DaQi0510/SM2200-Ulimate/PCB/Ven2.0/SM2200料单.xlsx

Comment | Designator | Footprint | Quantity | Value | 备注
电容部分 | C1, C2, C3, C4, C5, C6, C7, C8, C9, C10, C11, C12, C14, C15, C18,C20, C21, C22, C23, C24, C25, C26,C30, C59, C61,C63, C68, C69, C70, C72, C74,C76,C80, C81,C84,C86,C88,C89, C90,C92,C94,C99,C101,C102, C103,C105, C108,C110,C112,C114,C117,C124,C125 | 0603 | 53 | 0.1uF | 电路板背面电容均为0603封装，0.1uF电容
 | C29, C32, C34, C36, C38, C40, C41, C44, C45, C47, C50, C51, C54, C55, C58 | 0805 | 15 | 0.1uF
 | C17,C19 | 0603 | 2 | 20pF
 | C13,C16,C91,C93,C98,C100,C104,C109,C111,C113,C115,C116 | 0603 | 12 | 2.2uF
 | C27 | 0603 | 1 | 330pF
 | C122, C123 | 0603 | 2 | 22pF
 | C62,C64,C75,C82 | 0603 | 4 | 10nF
 | C65, C71,C77,C83 | 0603 | 4 | 18pF
 | C85 | 0603 | 1 | 3pF
 | C87 | 0603 | 1 | 12pF
 | C95 | 0603 | 1 | 56pF
 | C96 | 0603 | 1 | 1uF
 | C97 | 0603 | 1 | 220pF
 | C106 | 0603 | 1 | 1nF
 | C107 | 0603 | 1 | 5.6pF
 | C119 | 0603 | 1 | 18nF
 | C120 | 0603 | 1 | 270pF
 | C121 | 0603 | 1 | 130pF
 | C118 | 0805 | 1 | 10uF
 | C28, C33 | 钽电容3528 | 2 | 10uF
 | C48, C49, C52, C53, C56, C57, C66, C67,C78, C79 | 钽电容1206 | 10 | 10uF
 | C60,C73 | 钽电容1206 | 2 | 3.3uF
 | C31, C37, C39 | 贴片铝电容8*10.3 | 3 | 100uF
 | C43, C46 | 贴片铝电容8*10.3 | 2 | 220uF | 材料中没有，需购买
 | C35, C42 | 贴片铝电容10*10 | 2 | 470uF
电阻部分 | R1, R2, R3, R4, R5, R6, R7, R8, R10, R13, R15, R32, R33, R36, R37, R39, R41, R42, R43, R45, R46, R47, R49, R50, R51, R52, R53, R54, R55, R63, R64, R66, R67, R68, R69, R70, R71, R72, R73, R74, R75, R82, R83, R85, R87, R92, R93, R94, R97, R98, R101, R102, R104, R108, | 0603 | 54 | 10K
 | R9, R17 | 0603 | 2 | 47K
 | R11, R18 | 0603 | 2 | 0R
 | R12, R16 | 0603 | 2 | 22R
 | R14 | 0603 | 1 | 120R
 | R106, R107, R109, R19, R20, R21, R22, R27, R28, R29, R44, R48, R62, R65, R96,R103, R105 | 0603 | 17 | 1K
 | R23, R24, R25, R26, R30, R34, R38, R40, R110, R111 | 0603 | 10 | 4.7K
 | R61,R80, R112, | 0603 | 3 | 1M
 | R31, R100 | 0603 | 2 | 100R
 | R35 | 0603 | 1 | 100K
 | R56, R58, R59, R60, R77, R78, R79, R81 | 0603 | 8 | 50R
 | R57, R76 | 0603 | 2 | 28.7K
 | R84 | 0603 | 1 | 4.99K
 | R86 | 0603 | 1 | 2.2K
 | R88, R89, R90, R91 | 0603 | 4 | 100K
 | R95 | 0603 | 1 | 3.3K
 | R99 | 0603 | 1 | 330R
电感部分 | L1, L5, L6, L7, L8, L9, L10 | 0805 | 7 | 10uH
 | L2, L12 | 贴片7.8*7*5 | 2 | 330uH
 | L3, L4 | SLF6025 电感 | 2 | 33uH
 | L11 | 1206 | 1 | 1uH
 | L13 | 直插 | 1 | 18mH
三极管 | Q1, Q2, Q3, Q4, Q5, Q6, Q8, Q9, Q10, Q11 | 贴片 | 10 | BC847
 | Q7 | 贴片 | 1 | BC857
二极管 | D1, D2 | 贴片 | 2 | SMBJ20A
 | D3, D4 | 贴片 | 2 | IN5824 | 可能材料里没有，需购买
 | D5, D6, D7, D8 | 贴片 | 4 | SSA34
晶振 | X1 | 3225 | 1 | 8M
 | X2, X3 | 3225 | 1 | 25M
 | X4 | 3225 | 1 | 10M
 | U1 | 贴片 | 1 | STM32F407ZET6
 | U2 | 10*2排针 | 1 | 双排针
 | U3 | 贴片 | 1 | AT24C02
 | U4 | 贴片 | 1 | MAX3485
 | U5 | 贴片 | 1 | MAX3232
 | U6 | 贴片 | 1 | FDC6326L
 | U7，U8 | 贴片 |  |  | 不用焊接
 | U9 | 贴片 | 1 | LM2576HVS-15V
 | U10，U11 | 贴片 | 2 | LM2596-5
 | U12, U13, U14 | 贴片 | 3 | LT1963-3.3
 | U15, U17 | 直插 | 2 | RJ45接口
 | U16, U18 | 贴片 | 2 | W5200
 | U19 | 贴片 | 1 | SM2200
 | U20 | 贴片 | 1 | OPA564AIDWDR
 | B1 | 直插 | 1 | BNC
 | J1 | 直插 | 1 | DB9
 | J2 | 直插 | 1 | 三脚航空插头 | 不用焊接
 | K1 | 贴片 | 1 | 贴片按键
 | K2, K4 | 直插 | 2 | 选择开关
 | K3 | 直插 | 1 | T型接头
 | 右下方8*2焊盘焊接上排针
