DaQi0510/SM2200-Ulimate/PCB/Ven2.0/SM2200-PCB-2.pdf

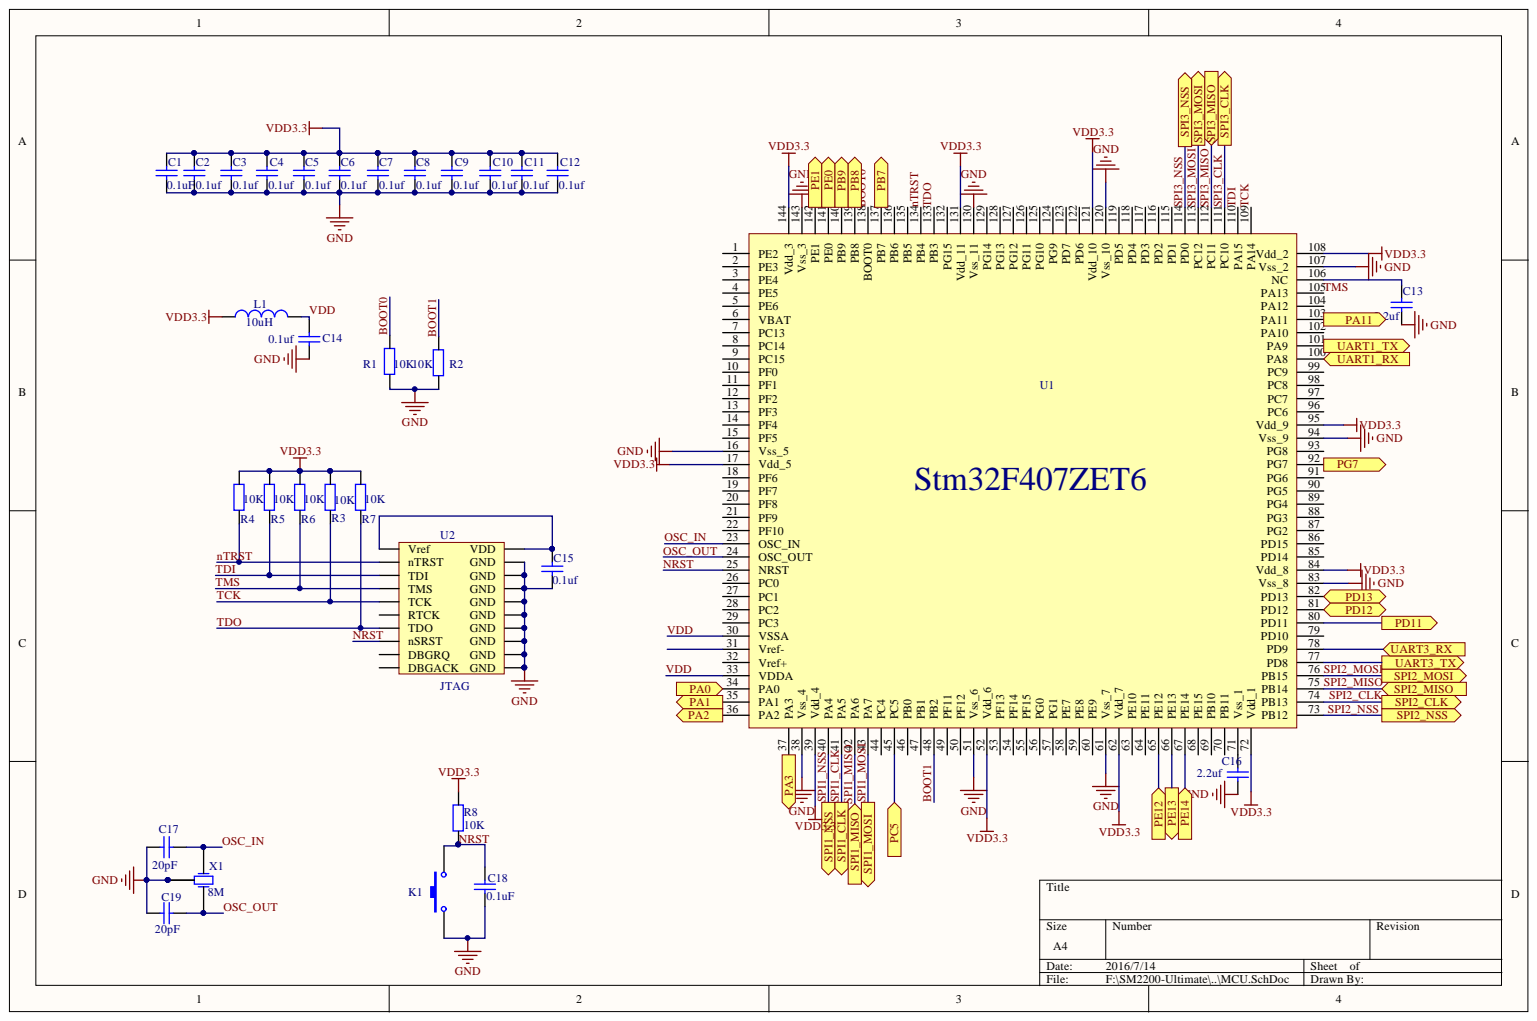
[picture p1: page 1]

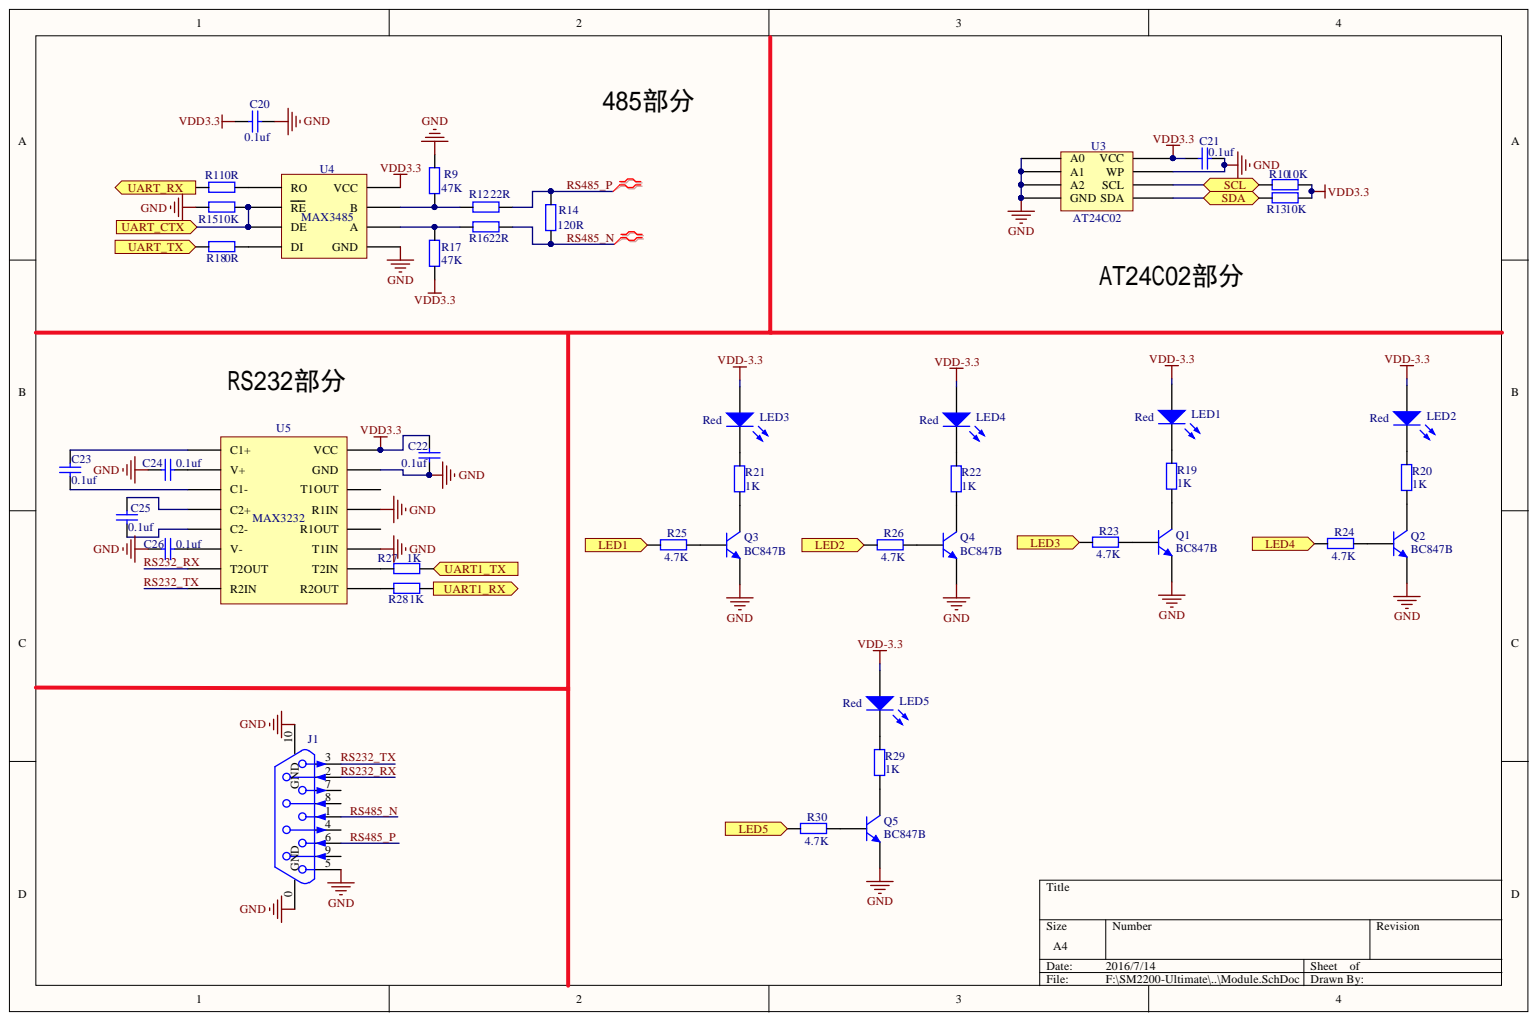
[picture p2: page 2]

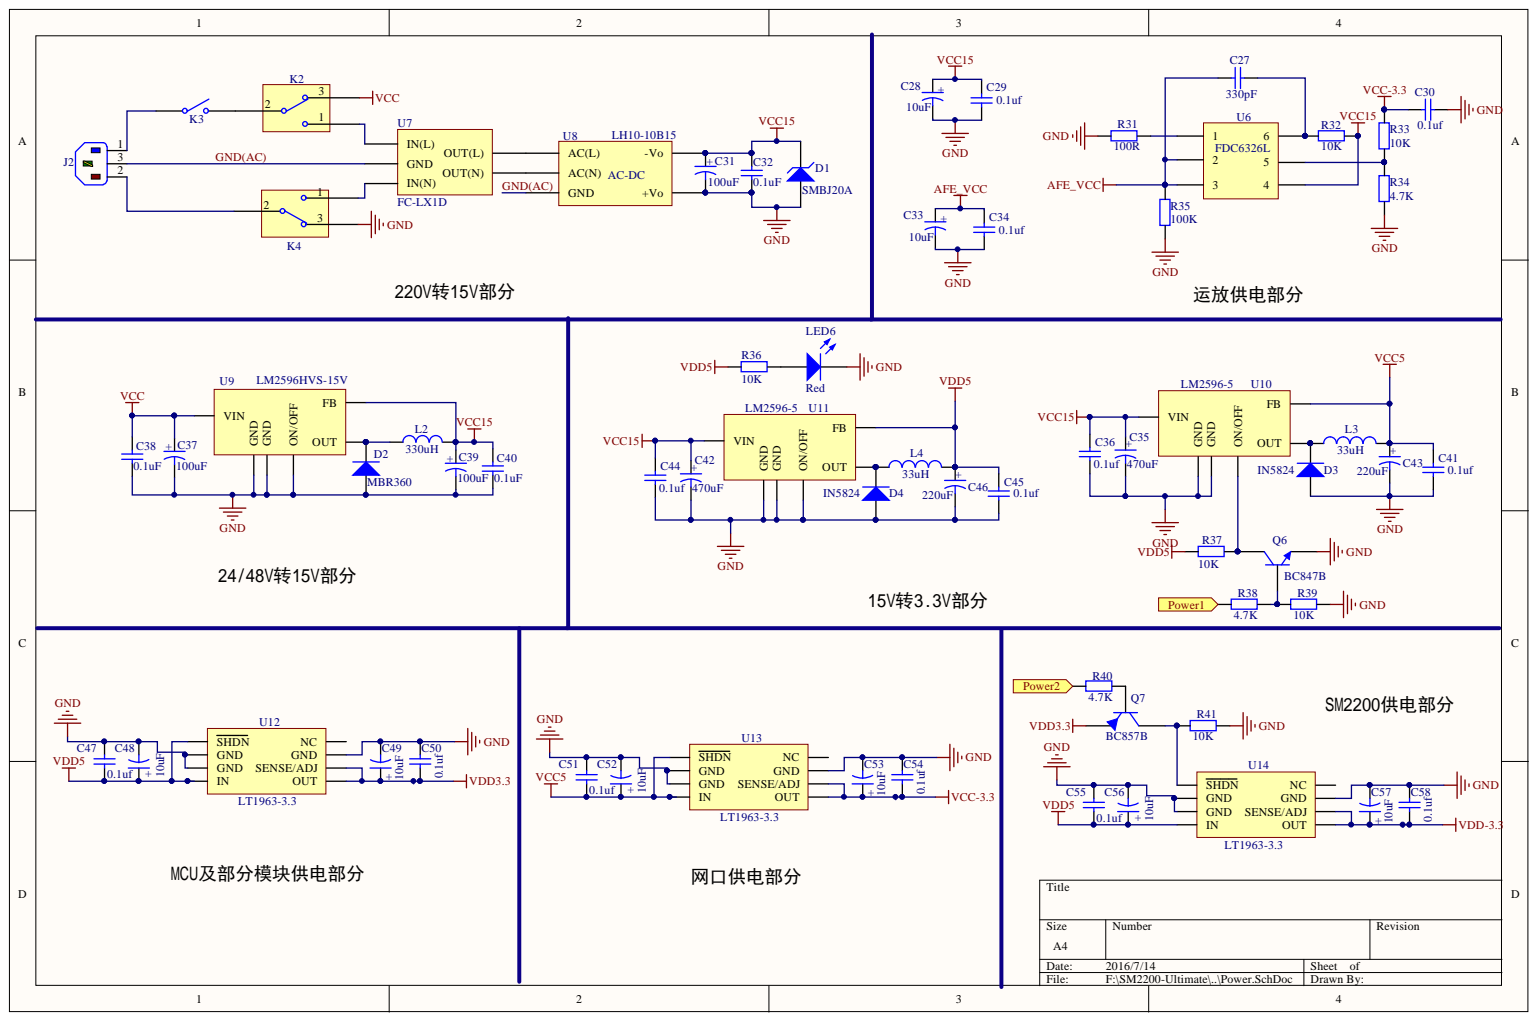
[picture p3: page 3]

MBR360 | 100uF

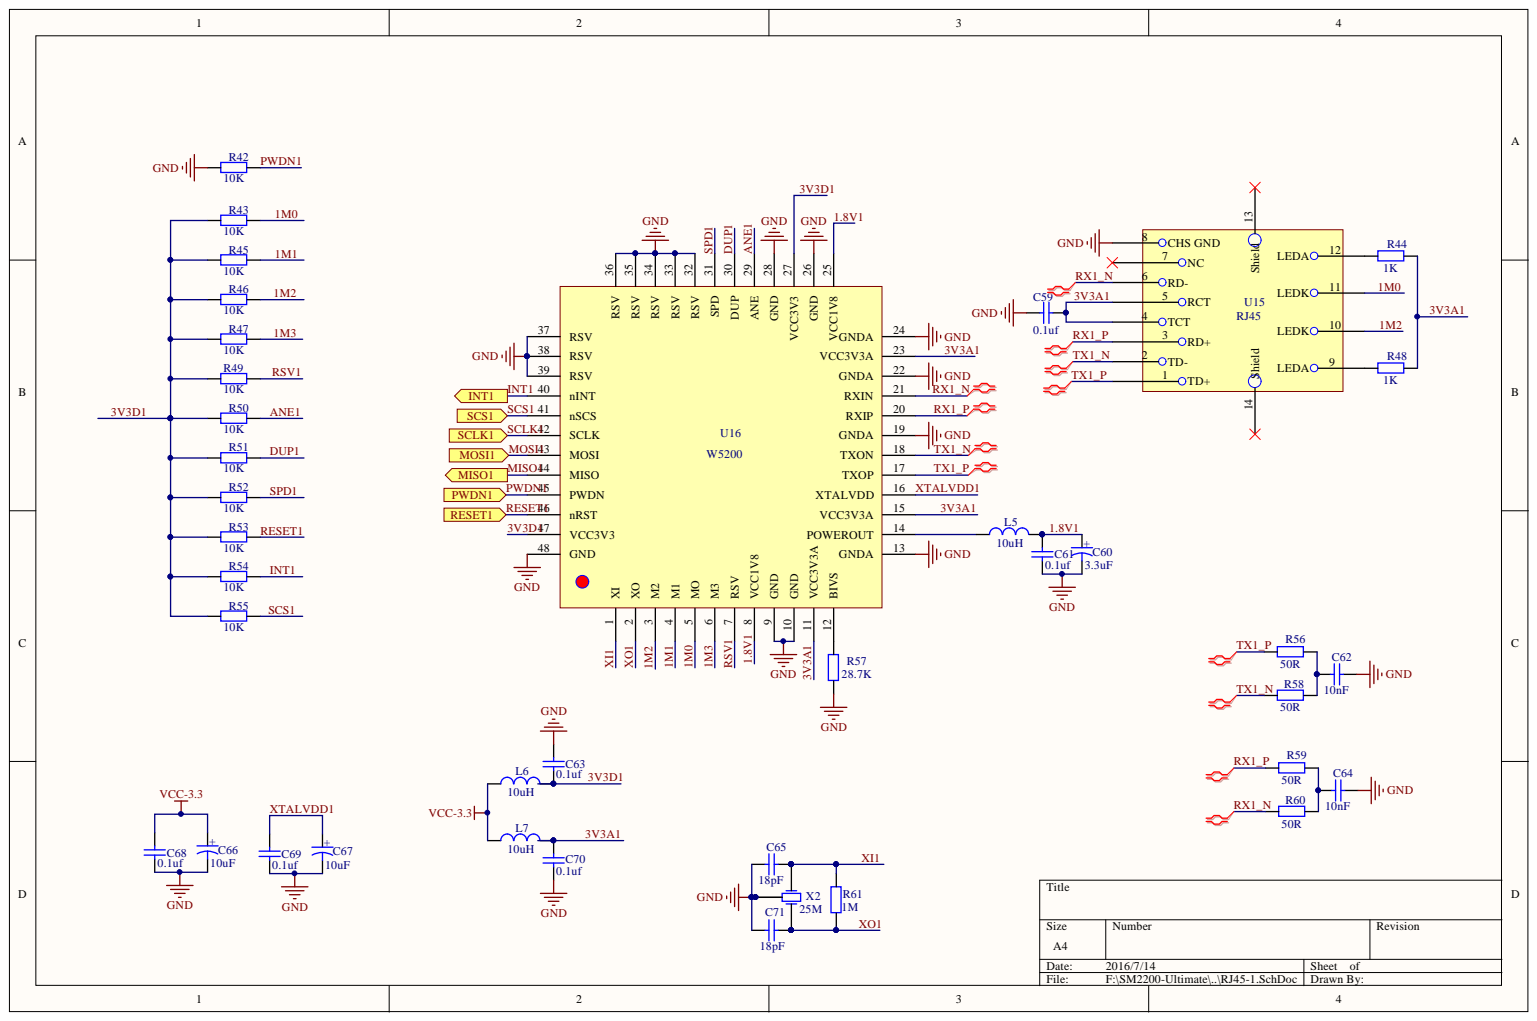
[picture p4: page 4]

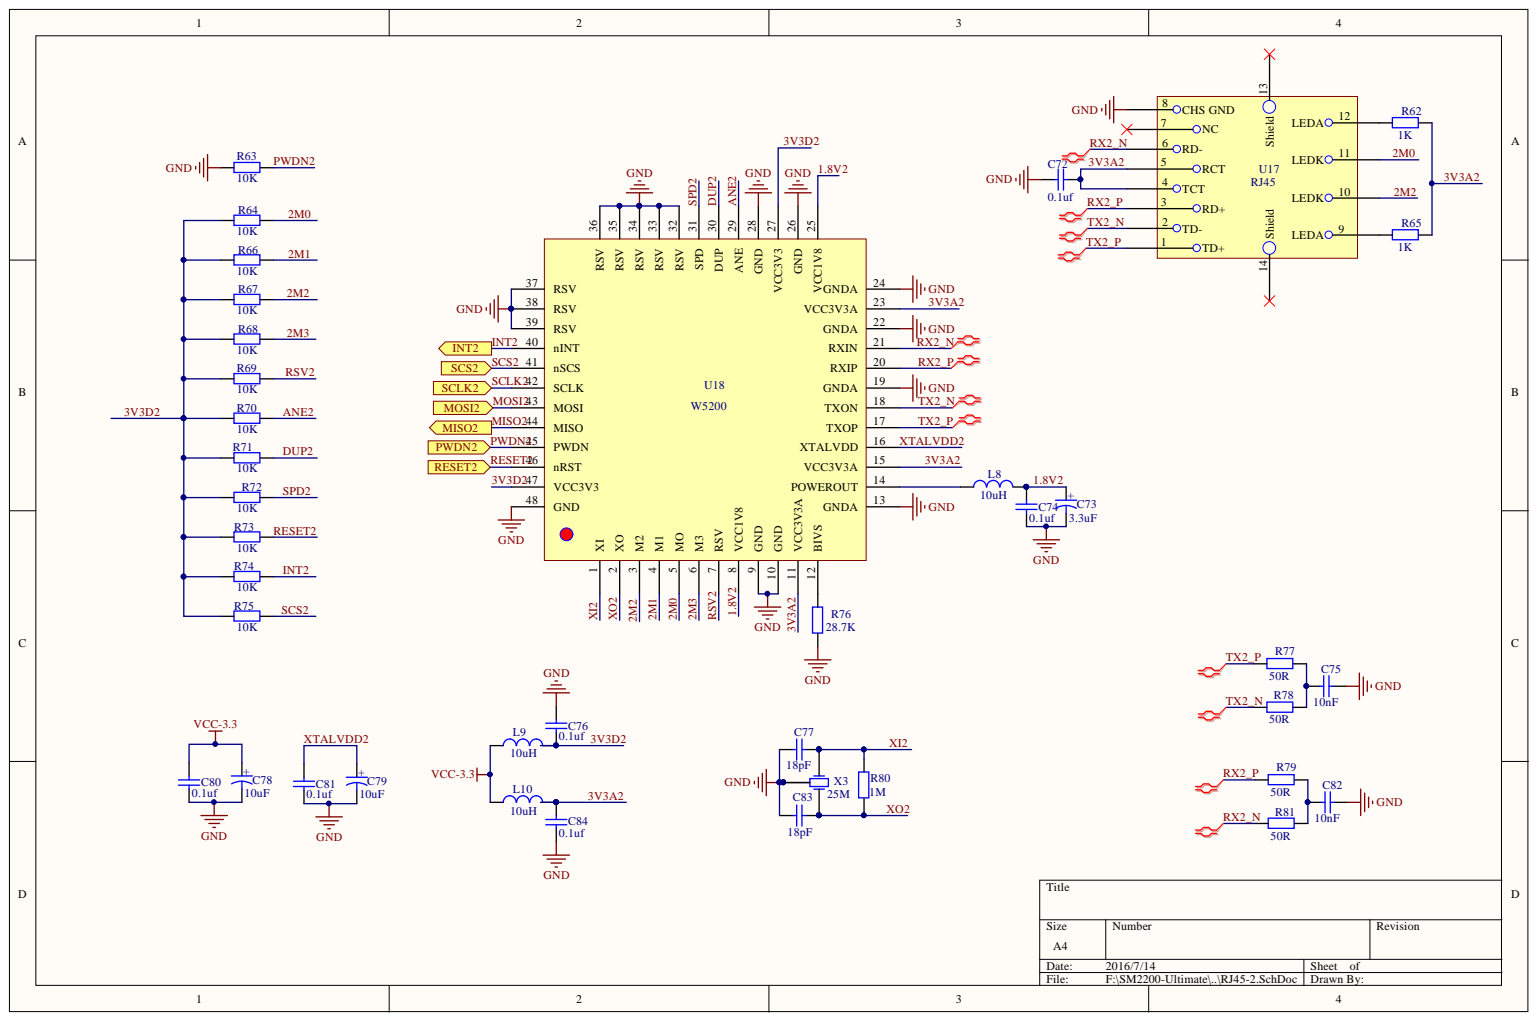
[picture p5: page 5]

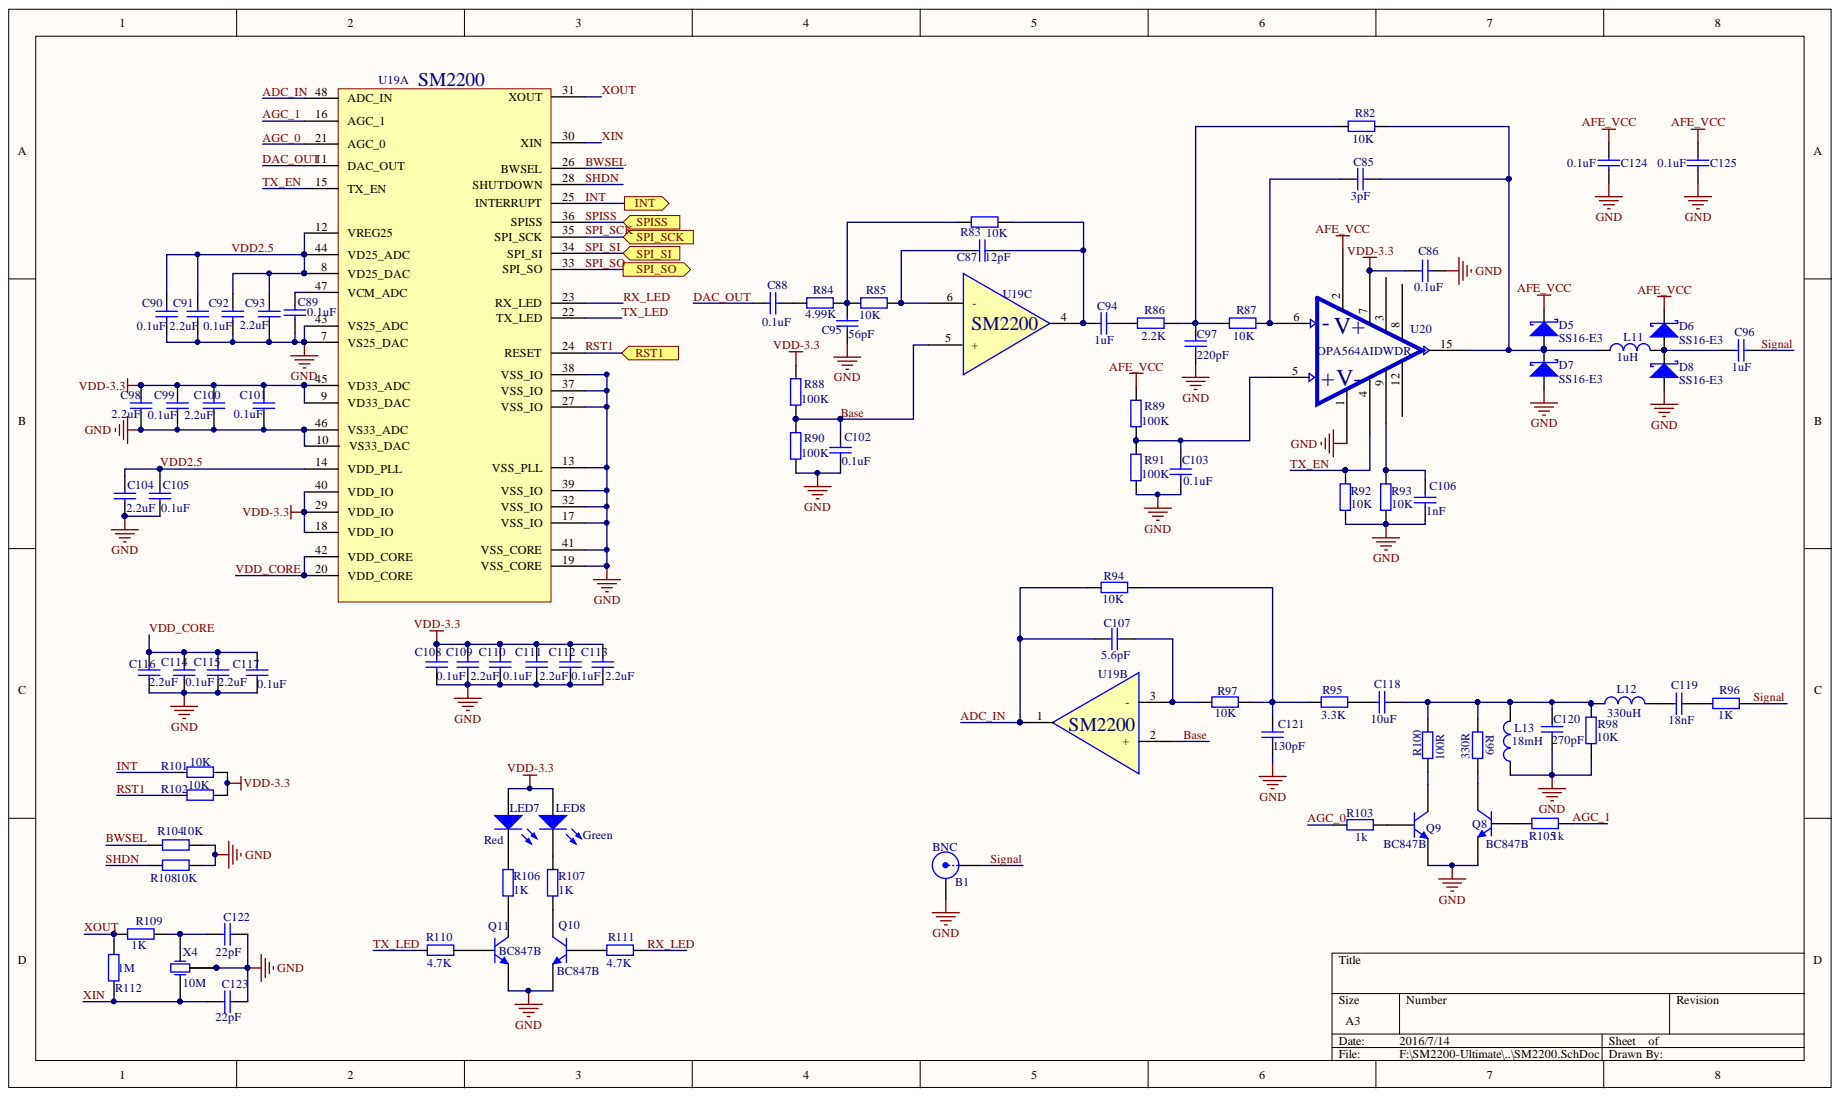
[picture p6: page 6]

AFE_VCC 6 | GND

VDD2.5 | VD25_ADC 44

C99 | C100 | C101 | VD33_DAC 9

VS33_ADC 46

Size A3 | Number | Revision

Date: 2016/7/14 | Sheet of
File: F:\SM2200-Ultimate\..\SM2200.SchDoc | Drawn By:

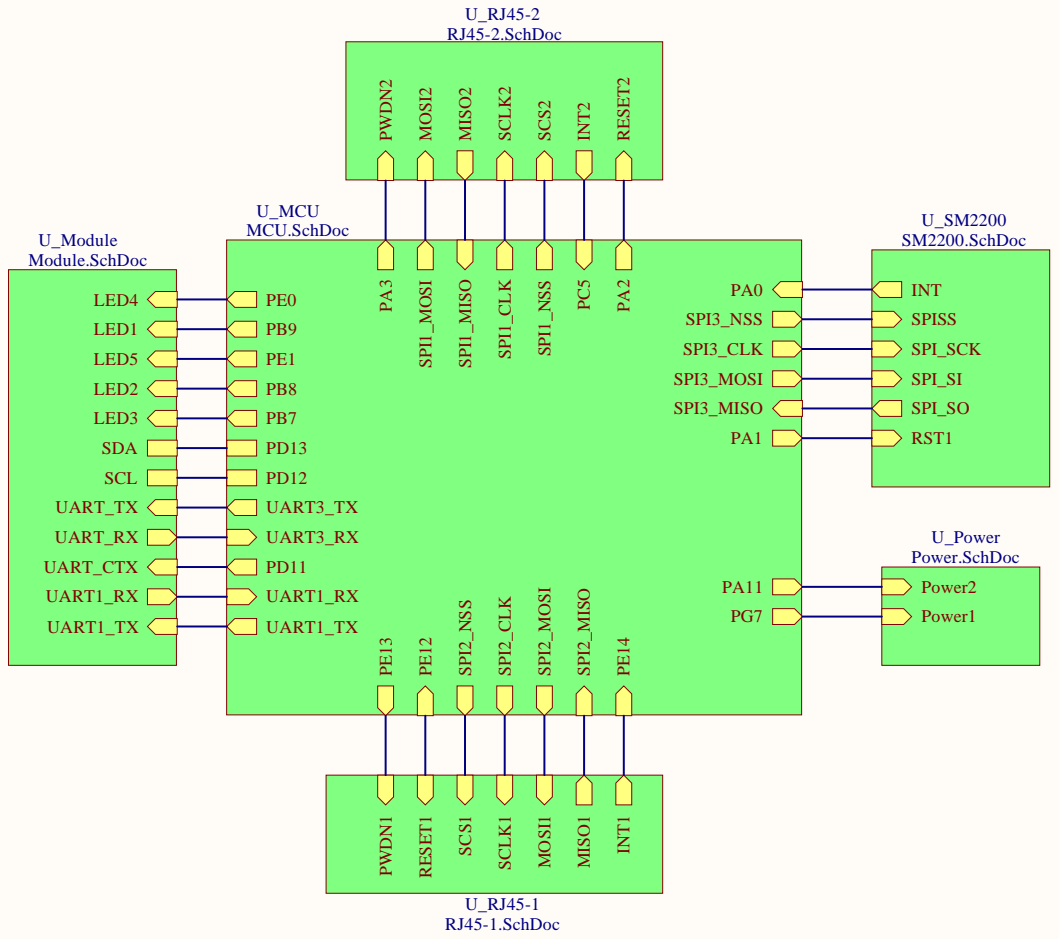
[picture p7: page 7]

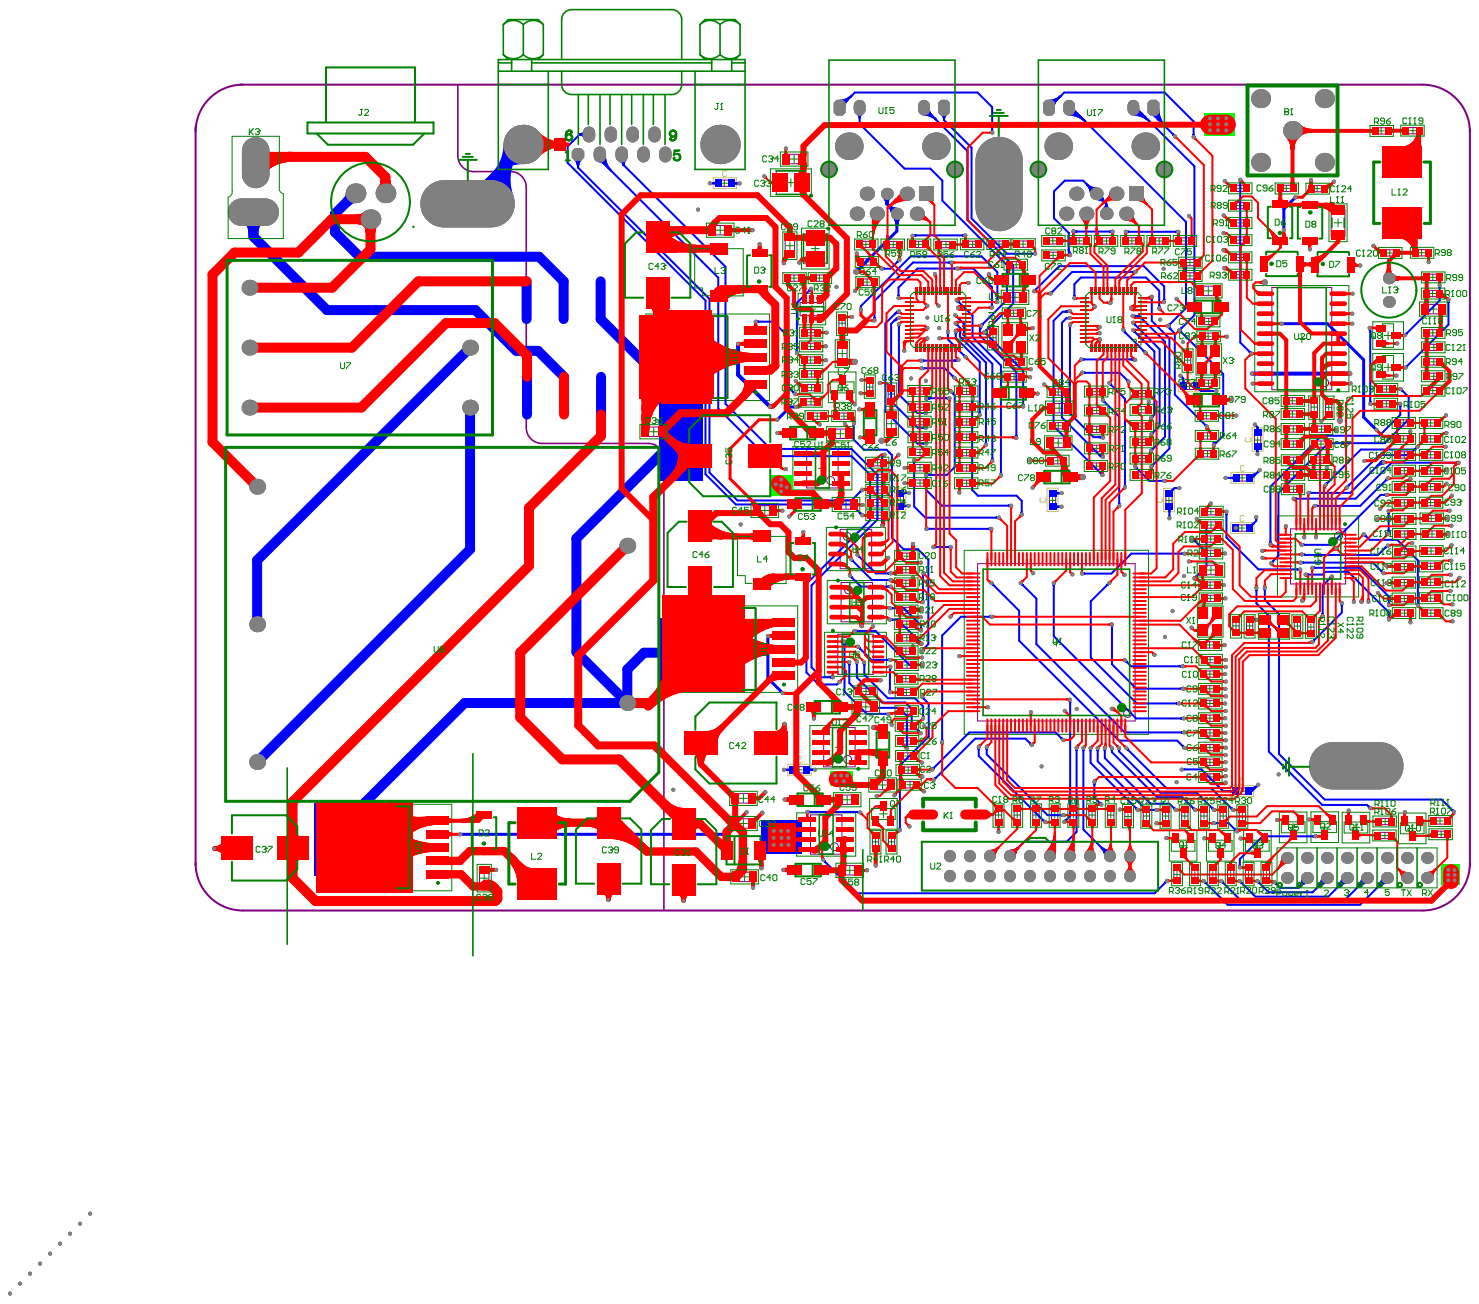
[picture p8: page 8]
