DaQi0510/SM2200-Ulimate/PCB/Ven3.0/Main/SM2200.pdf

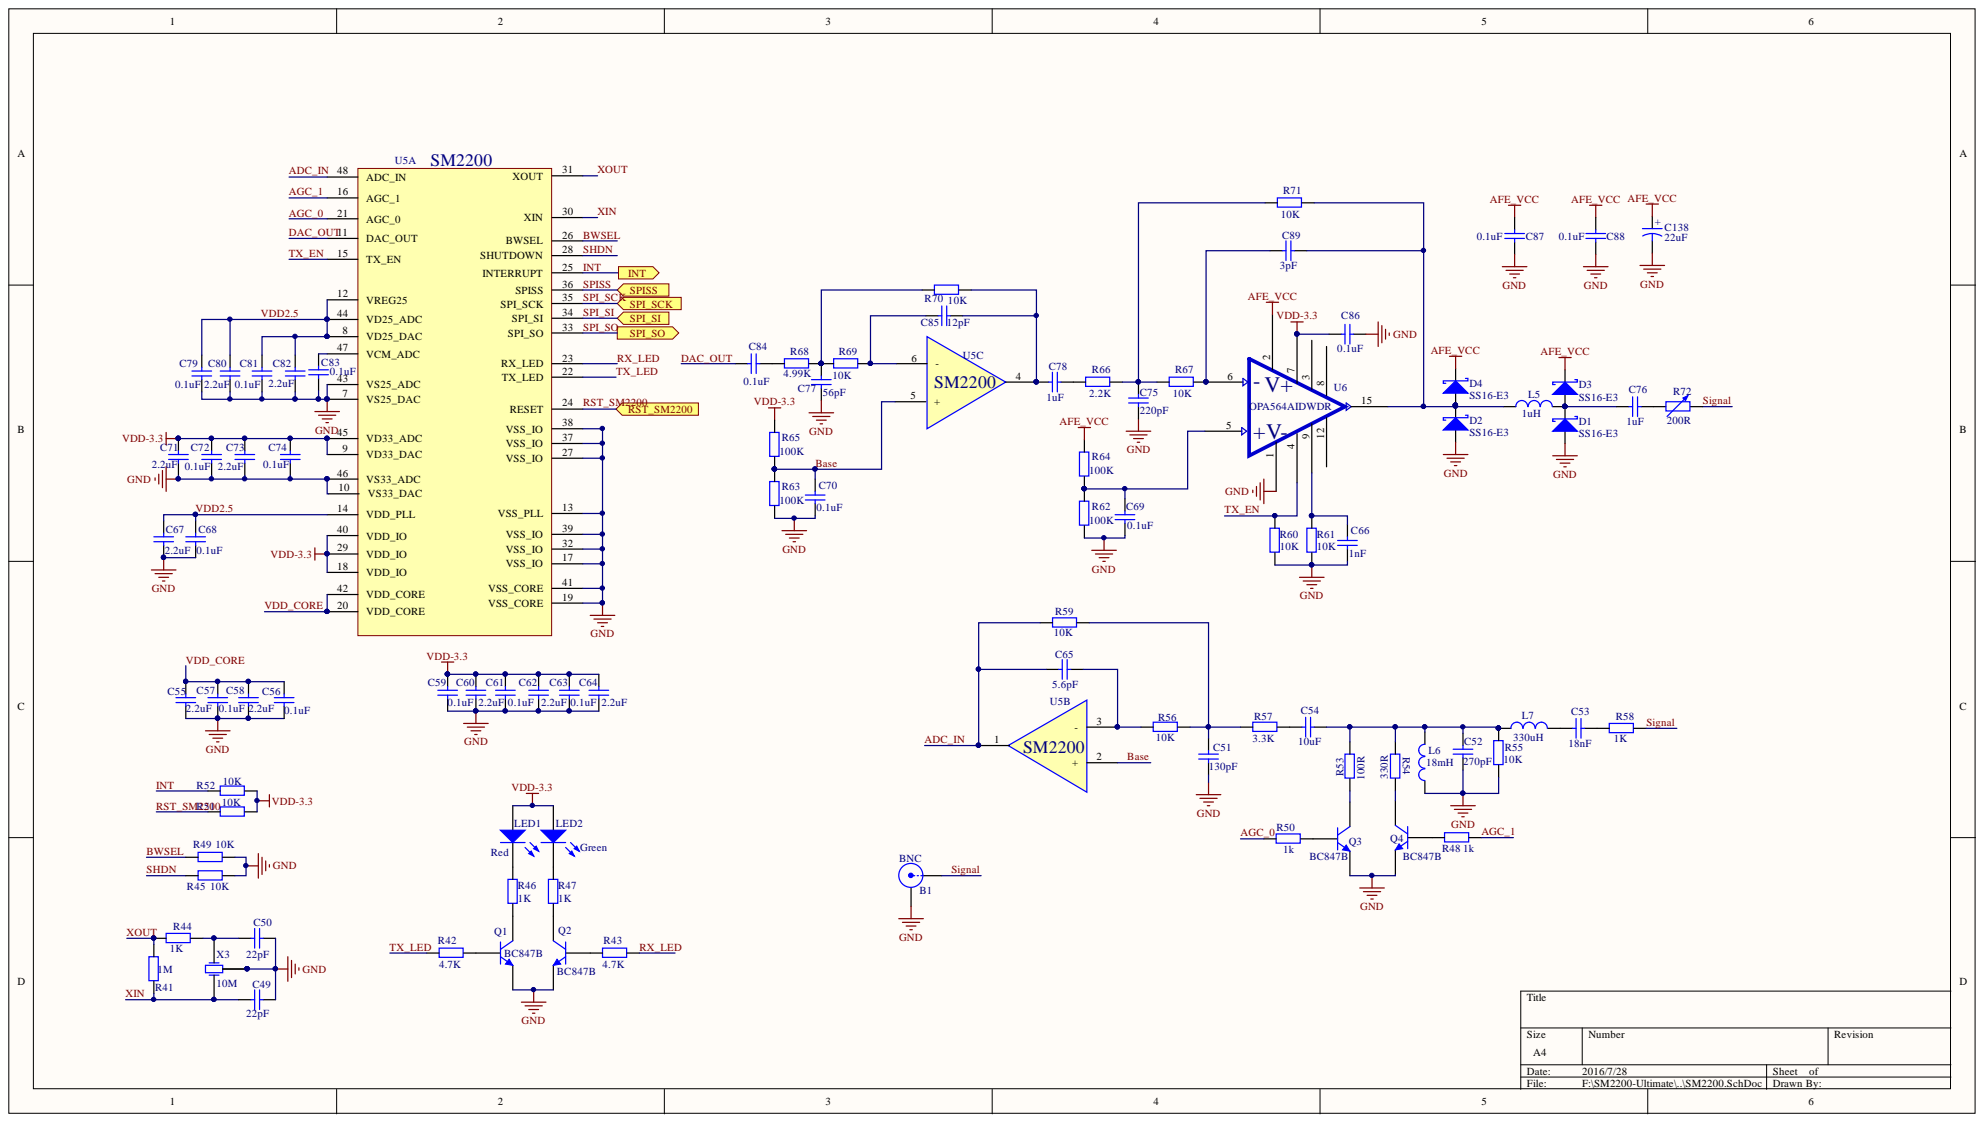
[picture p24: page 1]

AFE_VCC 6 | C86

VDD2.5

C72 | C73 | C74 | VD33_DAC 9

VS33_ADC 46

Size A4 | Number | Revision

Date: 2016/7/28 | Sheet of
File: F:\SM2200-Ultimate\..\SM2200.SchDoc | Drawn By:
