DaQi0510/SM2200-Ulimate/(list of files, drawings)

Other design files:
PCB/Ven1.0/GC2200.SchDoc
PCB/Ven1.0/MCU.SchDoc
PCB/Ven1.0/Module.SchDoc
PCB/Ven1.0/Power.SchDoc
PCB/Ven1.0/RJ45-2.SchDoc
PCB/Ven1.0/RJ45.SchDoc
PCB/Ven1.0/SM2200-PCB-1.PrjPCB
PCB/Ven1.0/Top.SchDoc
PCB/Ven2.0/History/Board.~(2).PcbDoc
PCB/Ven2.0/History/Board.~(3).PcbDoc
PCB/Ven2.0/History/Board.~(39).PcbDoc
PCB/Ven2.0/History/Board.~(48).PcbDoc
PCB/Ven2.0/History/MCU.~(2).SchDoc
PCB/Ven2.0/History/MCU.~(5).SchDoc
PCB/Ven2.0/History/Power.~(1).SchDoc
PCB/Ven2.0/History/Power.~(5).SchDoc
PCB/Ven2.0/MCU.SchDoc
PCB/Ven2.0/Module.SchDoc
PCB/Ven2.0/Power.SchDoc
PCB/Ven2.0/RJ45-1.SchDoc
PCB/Ven2.0/RJ45-2.SchDoc
PCB/Ven2.0/SM2200-PCB-2.PrjPCB
PCB/Ven2.0/SM2200.SchDoc
PCB/Ven2.0/Top.SchDoc
PCB/Ven3.0/HighPower/HighPower.PcbDoc
PCB/Ven3.0/HighPower/HighPower.SchDoc
PCB/Ven3.0/HighPower/SM2200_POWER.PrjPcb
PCB/Ven3.0/Main/MCU.SchDoc
PCB/Ven3.0/Main/Module.SchDoc
PCB/Ven3.0/Main/Power.SchDoc
PCB/Ven3.0/Main/SM2200.SchDoc
PCB/Ven3.0/Main/SM2200_PCB.PrjPCB
PCB/Ven3.0/Main/Top.SchDoc
PCB/Ven3.0/Main/W5500_1.SchDoc
PCB/Ven3.0/Main/W5500_2.SchDoc
