DaQi0510/SM2200-Ulimate/Stm32_Code/Ven2.0/HardWare/UART/UART.c

#include "uart.h"	
#include "led.h"
#include "stm32f4xx_rcc.h"

extern u8 Flag101;      //101规约数据接收标志
u8 StartFlag;           //报文开始标志
u8 Message101[256];    //存放接收到的101规约
u8 Index101;           //数组索引     

void uart_init(u32 bound)
{
   //GPIO端口设置
  GPIO_InitTypeDef GPIO_InitStructure;
	USART_InitTypeDef USART_InitStructure;
	NVIC_InitTypeDef NVIC_InitStructure;
	
	RCC_AHB1PeriphClockCmd(RCC_AHB1Periph_GPIOA,ENABLE); //使能GPIOA时钟
	RCC_APB2PeriphClockCmd(RCC_APB2Periph_USART1,ENABLE);//使能USART1时钟
  
	RCC_AHB1PeriphClockCmd(RCC_AHB1Periph_GPIOA, ENABLE);//使能GPIOA时钟
  GPIO_InitStructure.GPIO_Pin = GPIO_Pin_8;         
  GPIO_InitStructure.GPIO_Mode = GPIO_Mode_IN;//普通输入模式
  GPIO_InitStructure.GPIO_Speed = GPIO_Speed_100MHz;//100M
  GPIO_InitStructure.GPIO_PuPd = GPIO_PuPd_UP;//上拉
  GPIO_Init(GPIOA, &GPIO_InitStructure);//初始化GPIO	
	 
	//串口1对应引脚复用映射
	GPIO_PinAFConfig(GPIOA,GPIO_PinSource9,GPIO_AF_USART1); //GPIOA9复用为USART1
	GPIO_PinAFConfig(GPIOA,GPIO_PinSource10,GPIO_AF_USART1); //GPIOA10复用为USART1
	
	//USART1端口配置
  GPIO_InitStructure.GPIO_Pin = GPIO_Pin_9 | GPIO_Pin_10; //GPIOA9与GPIOA10
	GPIO_InitStructure.GPIO_Mode = GPIO_Mode_AF;//复用功能
	GPIO_InitStructure.GPIO_Speed = GPIO_Speed_50MHz;	//速度50MHz
	GPIO_InitStructure.GPIO_OType = GPIO_OType_PP; //推挽复用输出
	GPIO_InitStructure.GPIO_PuPd = GPIO_PuPd_UP; //上拉
	GPIO_Init(GPIOA,&GPIO_InitStructure); //初始化PA9，PA10

   //USART1 初始化设置
	USART_InitStructure.USART_BaudRate = bound;//波特率设置
	USART_InitStructure.USART_WordLength = USART_WordLength_8b;//字长为8位数据格式
	USART_InitStructure.USART_StopBits = USART_StopBits_1;//一个停止位
	USART_InitStructure.USART_Parity = USART_Parity_No;//无奇偶校验位
	USART_InitStructure.USART_HardwareFlowControl = USART_HardwareFlowControl_None;//无硬件数据流控制
	USART_InitStructure.USART_Mode = USART_Mode_Rx | USART_Mode_Tx;	//收发模式
  USART_Init(USART1, &USART_InitStructure); //初始化串口1
	
  USART_Cmd(USART1, ENABLE);  //使能串口1 
	

	USART_ITConfig(USART1, USART_IT_RXNE, ENABLE);//开启相关中断

	//Usart1 NVIC 配置
  NVIC_InitStructure.NVIC_IRQChannel = USART1_IRQn;//串口1中断通道
	NVIC_InitStructure.NVIC_IRQChannelPreemptionPriority=2;//抢占优先级3
	NVIC_InitStructure.NVIC_IRQChannelSubPriority =2;		//子优先级3
	NVIC_InitStructure.NVIC_IRQChannelCmd = ENABLE;			//IRQ通道使能
	NVIC_Init(&NVIC_InitStructure);	//根据指定的参数初始化VIC寄存器、

}

void USART_Send(u8 *Message,u8 Length)
{
	u8 i;
	for(i=0;i<Length;i++)
	{
		USART1->DR =Message[i];
		while((USART1->SR&0X40)==0);//等待发送结束
	}
}

void USART1_IRQHandler(void)                	//串口1中断服务程序
{
  u8 Res;
	if(USART_GetITStatus(USART1, USART_IT_RXNE) != RESET)  //接收中断(接收到的数据必须是0x0d 0x0a结尾)
	{
		Res =USART_ReceiveData(USART1);
	  if((StartFlag==0)&&((Res==0x10)||(Res==0x68)))
		{
			StartFlag=1;
			Index101=0;
		}
		Message101[Index101]=Res;
		Index101++;
		if((Message101[0]==0x10)&&(Index101==5))    //固定帧格式，接收完成
		{
//			Flag101=1;
			StartFlag=0;
		}
		if((Message101[0]==0x68)&&(Index101==Message101[1]+6))    //固定帧格式，接收完成
		{
//			Flag101=1;
			StartFlag=0;
		}
	}  
  LED2 =!LED2 ;	
} 
