DaQi0510/SM2200-Ulimate/Stm32_Code/Ven1.0/HardWare/LCD/LCD.h

#ifndef __LCD_H
#define __LCD_H

#include "stm32f4xx_gpio.h"
#include "delay.h"

#define SET_LCD_DC GPIO_SetBits(GPIOF,GPIO_Pin_0)    //  PF0  片选
#define CLR_LCD_DC GPIO_ResetBits(GPIOF,GPIO_Pin_0)

#define SET_LCD_RST GPIO_SetBits(GPIOF,GPIO_Pin_1)    //  PF1  复位
#define CLR_LCD_RST GPIO_ResetBits(GPIOF,GPIO_Pin_1)

#define SET_LCD_SDA GPIO_SetBits(GPIOF,GPIO_Pin_2)   //  PF2  数据位
#define CLR_LCD_SDA GPIO_ResetBits(GPIOF,GPIO_Pin_2)

#define SET_LCD_SCL GPIO_SetBits(GPIOF,GPIO_Pin_3)    //  PF3  数据位
#define CLR_LCD_SCL GPIO_ResetBits(GPIOF,GPIO_Pin_3)

 void LCD_Init(void);
 void LCD_P6x8Str(u8 x,u8 y,u8 ch[]);
 void LCD_ShowNum(u8 x,u8 y, unsigned int num);
 void LCD_Show_M(u8 y,unsigned long int num);
 
#endif
