DaQi0510/SM2200-Ulimate/Stm32_Code/Ven2.0/STM32F407/USER/spi.c

#include "spi.h"

/******************************************************************************/
/*                              SPI1初始化                                    */
/******************************************************************************/

void spi1_init(void)
{	 
	GPIO_InitTypeDef  GPIO_InitStructure;
  SPI_InitTypeDef  SPI_InitStructure;
	
	///////////////////////////////////////////////////////////////////////
	////                        SPI1 GPIO配置                          ////
	///////////////////////////////////////////////////////////////////////
	
  RCC_AHB1PeriphClockCmd(RCC_AHB1Periph_GPIOA, ENABLE);//使能GPIOA时钟

	GPIO_InitStructure.GPIO_Pin = GPIO_Pin_5 | GPIO_Pin_6;//PA5 PA6复用功能输出	
  GPIO_InitStructure.GPIO_Mode = GPIO_Mode_AF;//复用功能
  GPIO_InitStructure.GPIO_OType = GPIO_OType_PP;//推挽输出
  GPIO_InitStructure.GPIO_Speed = GPIO_Speed_100MHz;//100MHz
  GPIO_InitStructure.GPIO_PuPd = GPIO_PuPd_UP;//上拉
  GPIO_Init(GPIOA, &GPIO_InitStructure);//初始化
	
	GPIO_PinAFConfig(GPIOA,GPIO_PinSource5,GPIO_AF_SPI1); //PA5复用为 SPI1
	GPIO_PinAFConfig(GPIOA,GPIO_PinSource6,GPIO_AF_SPI1); //PA6复用为 SPI1

	///////////////////////////////////////////////////////////////////////
	////                         SPI1配置                               ////
	///////////////////////////////////////////////////////////////////////
	
	RCC_APB2PeriphClockCmd(RCC_APB2Periph_SPI1, ENABLE);//使能SPI1时钟

	SPI_InitStructure.SPI_Direction = SPI_Direction_2Lines_FullDuplex;  //SPI设置为双线双向全双工
	SPI_InitStructure.SPI_Mode = SPI_Mode_Master;		//设置为主SPI
	SPI_InitStructure.SPI_DataSize = SPI_DataSize_8b;		//SPI发送接收8位帧结构
	SPI_InitStructure.SPI_CPOL = SPI_CPOL_Low;		//串行同步时钟的空闲状态为低电平
	SPI_InitStructure.SPI_CPHA = SPI_CPHA_1Edge;	//串行同步时钟的第一个跳变沿（上升沿）数据被采样
	SPI_InitStructure.SPI_NSS = SPI_NSS_Soft;		//NSS信号由硬件（NSS管脚）还是软件（使用SSI位）管理:内部NSS信号有SSI位控制
	SPI_InitStructure.SPI_BaudRatePrescaler = SPI_BaudRatePrescaler_8;		//定义波特率预分频的值:波特率预分频值为16
	SPI_InitStructure.SPI_FirstBit = SPI_FirstBit_MSB;	//指定数据传输从MSB位还是LSB位开始:数据传输从MSB位开始
	SPI_InitStructure.SPI_CRCPolynomial = 7;	//CRC值计算的多项式
	
	SPI_Init(SPI1, &SPI_InitStructure);  //根据SPI_InitStruct中指定的参数初始化外设SPIx寄存器
	SPI_CalculateCRC(SPI1, DISABLE);
	SPI_Cmd(SPI1, ENABLE); //使能SPI外设
	
}

/******************************************************************************/
/*                              SPI2初始化                                    */
/******************************************************************************/

void spi2_init(void)
{	 
	GPIO_InitTypeDef  GPIO_InitStructure;
  SPI_InitTypeDef  SPI_InitStructure;
	
	///////////////////////////////////////////////////////////////////////
	////                        SPI2 GPIO配置                          ////
	///////////////////////////////////////////////////////////////////////
	
  RCC_AHB1PeriphClockCmd(RCC_AHB1Periph_GPIOB, ENABLE);//使能GPIOB时钟

	GPIO_InitStructure.GPIO_Pin = GPIO_Pin_13 | GPIO_Pin_14;//PB13 PB14复用功能输出	
  GPIO_InitStructure.GPIO_Mode = GPIO_Mode_AF;//复用功能
  GPIO_InitStructure.GPIO_OType = GPIO_OType_PP;//推挽输出
  GPIO_InitStructure.GPIO_Speed = GPIO_Speed_100MHz;//100MHz
  GPIO_InitStructure.GPIO_PuPd = GPIO_PuPd_UP;//上拉
  GPIO_Init(GPIOB, &GPIO_InitStructure);//初始化
	
	GPIO_PinAFConfig(GPIOB,GPIO_PinSource13,GPIO_AF_SPI2); //PB13复用为 SPI2
	GPIO_PinAFConfig(GPIOB,GPIO_PinSource14,GPIO_AF_SPI2); //PB14复用为 SPI2

	///////////////////////////////////////////////////////////////////////
	////                         SPI2配置                               ////
	///////////////////////////////////////////////////////////////////////
	
	RCC_APB1PeriphClockCmd(RCC_APB1Periph_SPI2, ENABLE);//使能SPI2时钟

	SPI_InitStructure.SPI_Direction = SPI_Direction_2Lines_FullDuplex;  //SPI设置为双线双向全双工
	SPI_InitStructure.SPI_Mode = SPI_Mode_Master;		//设置为主SPI
	SPI_InitStructure.SPI_DataSize = SPI_DataSize_8b;		//SPI发送接收8位帧结构
	SPI_InitStructure.SPI_CPOL = SPI_CPOL_Low;		//串行同步时钟的空闲状态为低电平
	SPI_InitStructure.SPI_CPHA = SPI_CPHA_1Edge;	//串行同步时钟的第一个跳变沿（上升沿）数据被采样
	SPI_InitStructure.SPI_NSS = SPI_NSS_Soft;		//NSS信号由硬件（NSS管脚）还是软件（使用SSI位）管理:内部NSS信号有SSI位控制
	SPI_InitStructure.SPI_BaudRatePrescaler = SPI_BaudRatePrescaler_4;		//定义波特率预分频的值:波特率预分频值为16
	SPI_InitStructure.SPI_FirstBit = SPI_FirstBit_MSB;	//指定数据传输从MSB位还是LSB位开始:数据传输从MSB位开始
	SPI_InitStructure.SPI_CRCPolynomial = 7;	//CRC值计算的多项式
	
	SPI_Init(SPI2, &SPI_InitStructure);  //根据SPI_InitStruct中指定的参数初始化外设SPIx寄存器
	SPI_CalculateCRC(SPI2, DISABLE);
	SPI_Cmd(SPI2, ENABLE); //使能SPI外设
	
}

/******************************************************************************/
/*                              SPI1读写一个字节                              */
/******************************************************************************/

u8 SPI1_ReadWriteByte(u8 TxData)
{		 			 
 
  while (SPI_I2S_GetFlagStatus(SPI1, SPI_I2S_FLAG_TXE) == RESET){}//等待发送区空  
	
	SPI_I2S_SendData(SPI1, TxData); //通过外设SPIx发送一个byte  数据
		
  while (SPI_I2S_GetFlagStatus(SPI1, SPI_I2S_FLAG_RXNE) == RESET){} //等待接收完一个byte  
 
	return SPI_I2S_ReceiveData(SPI1); //返回通过SPIx最近接收的数据	
 		    
}

/******************************************************************************/
/*                              SPI2读写一个字节                              */
/******************************************************************************/

u8 SPI2_ReadWriteByte(u8 TxData)
{		 			 
 
  while (SPI_I2S_GetFlagStatus(SPI2, SPI_I2S_FLAG_TXE) == RESET){}//等待发送区空  
	
	SPI_I2S_SendData(SPI2, TxData); //通过外设SPIx发送一个byte  数据
		
  while (SPI_I2S_GetFlagStatus(SPI2, SPI_I2S_FLAG_RXNE) == RESET){} //等待接收完一个byte  
 
	return SPI_I2S_ReceiveData(SPI2); //返回通过SPIx最近接收的数据	
 		    
}
