DaQi0510/SM2200-Ulimate/Stm32_Code/Ven2.0/STM32F407/USER/agreement.h

#ifndef _PWM_H
#define _PWM_H
#include "sys.h"
#include "timer.h"
#include "sram.h"
#include "ethernet.h"

unsigned char deal_int(void);
unsigned char deal_pre(void);
unsigned char deal_div(void);
unsigned char deal_sta(void);
unsigned char deal_data(void);
	
#endif
