DaQi0510/SM2200-Ulimate/Stm32_Code/Ven2.0/STM32F407/USER/exti.c

#include "exti.h"

/******************************************************************************/
/*                              EXTI初始化                                    */
/******************************************************************************/

void exti_init(void)
{
	NVIC_InitTypeDef   NVIC_InitStructure;
	EXTI_InitTypeDef   EXTI_InitStructure;
	GPIO_InitTypeDef  GPIO_InitStructure;
	
	///////////////////////////////////////////////////////////////////////
	////                        GPIO配置                               ////
	///////////////////////////////////////////////////////////////////////
	
  RCC_AHB1PeriphClockCmd(RCC_AHB1Periph_GPIOA | RCC_AHB1Periph_GPIOB, ENABLE);//使能GPIOA,GPIOB时钟
 
  GPIO_InitStructure.GPIO_Pin = GPIO_Pin_4; //PA4
  GPIO_InitStructure.GPIO_Mode = GPIO_Mode_IN;//普通输入模式
  GPIO_InitStructure.GPIO_Speed = GPIO_Speed_100MHz;//100M
  GPIO_InitStructure.GPIO_PuPd = GPIO_PuPd_UP;//上拉
  GPIO_Init(GPIOA, &GPIO_InitStructure);//初始化GPIOA4
	
	GPIO_InitStructure.GPIO_Pin = GPIO_Pin_12; //PB12
  GPIO_InitStructure.GPIO_Mode = GPIO_Mode_IN;//普通输入模式
  GPIO_InitStructure.GPIO_Speed = GPIO_Speed_100MHz;//100M
  GPIO_InitStructure.GPIO_PuPd = GPIO_PuPd_UP;//上拉
  GPIO_Init(GPIOB, &GPIO_InitStructure);//初始化GPIOB12
	
	///////////////////////////////////////////////////////////////////////
	////                         中断配置                              ////
	///////////////////////////////////////////////////////////////////////
	
	RCC_APB2PeriphClockCmd(RCC_APB2Periph_SYSCFG, ENABLE);//使能SYSCFG时钟
	
	SYSCFG_EXTILineConfig(EXTI_PortSourceGPIOA, EXTI_PinSource4);//PA4 连接到中断线4
	SYSCFG_EXTILineConfig(EXTI_PortSourceGPIOB, EXTI_PinSource12);//PB12 连接到中断线0
	
	EXTI_InitStructure.EXTI_Line = EXTI_Line4 | EXTI_Line12;
  EXTI_InitStructure.EXTI_Mode = EXTI_Mode_Interrupt;//中断事件
  EXTI_InitStructure.EXTI_Trigger = EXTI_Trigger_Falling; //下降沿触发
  EXTI_InitStructure.EXTI_LineCmd = ENABLE;//中断线使能
  EXTI_Init(&EXTI_InitStructure);//配置

	///////////////////////////////////////////////////////////////////////
	////                         NVIC配置                              ////
	///////////////////////////////////////////////////////////////////////
	
	NVIC_InitStructure.NVIC_IRQChannel = EXTI4_IRQn;//外部中断4
  NVIC_InitStructure.NVIC_IRQChannelPreemptionPriority = 0x00;//抢占优先级0
  NVIC_InitStructure.NVIC_IRQChannelSubPriority = 0x00;//子优先级2
  NVIC_InitStructure.NVIC_IRQChannelCmd = ENABLE;//使能外部中断通道
  NVIC_Init(&NVIC_InitStructure);//配置
	
	NVIC_InitStructure.NVIC_IRQChannel = EXTI15_10_IRQn;//外部中断12
  NVIC_InitStructure.NVIC_IRQChannelPreemptionPriority = 0x00;//抢占优先级3
  NVIC_InitStructure.NVIC_IRQChannelSubPriority = 0x01;//子优先级2
  NVIC_InitStructure.NVIC_IRQChannelCmd = ENABLE;//使能外部中断通道
  NVIC_Init(&NVIC_InitStructure);//配置
	
}
