DaQi0510/SM2200-Ulimate/Stm32_Code/Ven2.0/STM32F407/USER/timer.c

#include "timer.h"

unsigned int TIM3_ms;

/******************************************************************************/
/*                              PWM初始化                                     */
/*                         SYSCLK为系统时钟(MHz)                              */
/******************************************************************************/

void tim3_init(u16 SYSCLK)
{
	TIM_TimeBaseInitTypeDef TIM_TimeBaseInitStructure;
	NVIC_InitTypeDef NVIC_InitStructure;
	
	RCC_APB1PeriphClockCmd(RCC_APB1Periph_TIM3,ENABLE);  ///使能TIM3时钟
	
  TIM_TimeBaseInitStructure.TIM_Period = 1000-1; 	//自动重装载值
	TIM_TimeBaseInitStructure.TIM_Prescaler=SYSCLK/2+1;  //定时器分频
	TIM_TimeBaseInitStructure.TIM_CounterMode=TIM_CounterMode_Up; //向上计数模式
	TIM_TimeBaseInitStructure.TIM_ClockDivision=TIM_CKD_DIV1; 
	
	TIM_TimeBaseInit(TIM3,&TIM_TimeBaseInitStructure);//初始化TIM3
	
	TIM_ITConfig(TIM3,TIM_IT_Update,ENABLE); //允许定时器3更新中断 溢出一次1ms
	TIM_Cmd(TIM3,ENABLE); //使能定时器3
	
	NVIC_InitStructure.NVIC_IRQChannel=TIM3_IRQn; //定时器3中断
	NVIC_InitStructure.NVIC_IRQChannelPreemptionPriority=0x01; //抢占优先级1
	NVIC_InitStructure.NVIC_IRQChannelSubPriority=0x03; //子优先级3
	NVIC_InitStructure.NVIC_IRQChannelCmd=ENABLE;
	NVIC_Init(&NVIC_InitStructure);
	
}

/******************************************************************************/
/*                              TIM3中断                                      */
/******************************************************************************/

void TIM3_IRQHandler(void)
{
	if(TIM_GetITStatus(TIM3,TIM_IT_Update)==SET) //溢出中断
	{
		TIM3_ms++;
	}
	TIM_ClearITPendingBit(TIM3,TIM_IT_Update);  //清除中断标志位
}
