DaQi0510/SM2200-Ulimate/(commit log)

2016-04-27 add PCB
    [GC2200.SchDoc, MCU.SchDoc, Module.SchDoc, Power.SchDoc, RJ45-1.SchDoc, RJ45-2.SchDoc, RJ45.SchDoc, SM2200-PCB-1.PrjPCB]
2016-07-04 update pcb ven3.0
    [Board.~(2).PcbDoc, Board.~(3).PcbDoc, Board.~(39).PcbDoc, Board.~(48).PcbDoc, HighPower.PcbDoc, HighPower.SchDoc, MCU.SchDoc, MCU.~(2).SchDoc]
2016-07-27 add w5500
    [SM2200-PCB-2.PrjPCB]
2016-08-11 add 数据格式说明 and modify PC_Code
2016-08-13 添加载波通信设置和回传等命令
2016-08-14 轮询程序调试完成
2016-08-15 网口客户端模式调试可用
2016-08-16 调整轮询方式部分命令
2016-08-22 添加各设备发送间隔50ms延时
2016-08-27 完成数据包调取上位机程序
2016-09-10 添加部分频点查找程序
